keyaee/practicum/parts/controller/IMG_2561.JPG

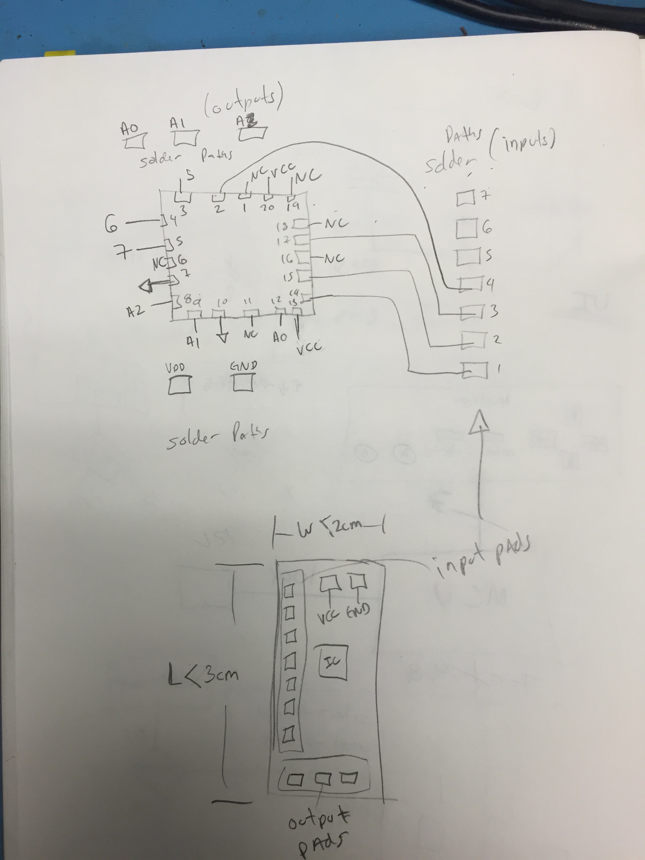
parts/controller/IMG_2561.JPG
