keyaee/practicum/images/ECE411 Lock Box - 1.jpg

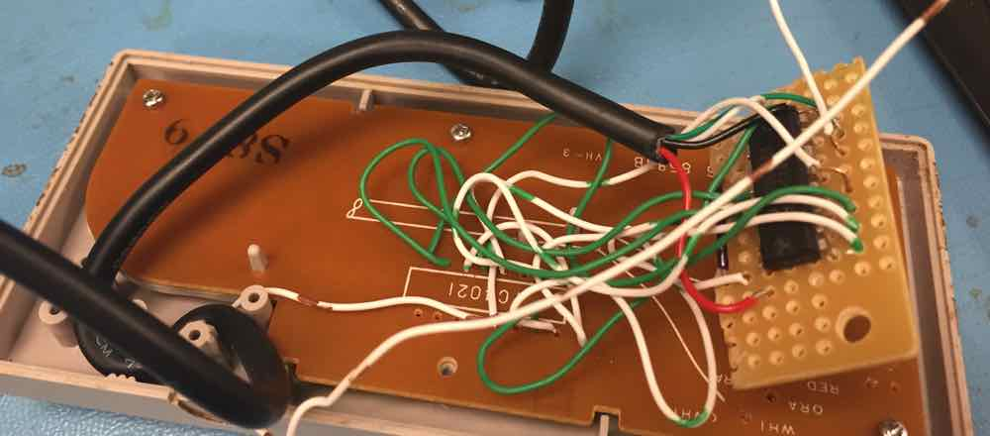
images/ECE411 Lock Box - 1.jpg
