keyaee/practicum/images/411blockDiagram.jpg

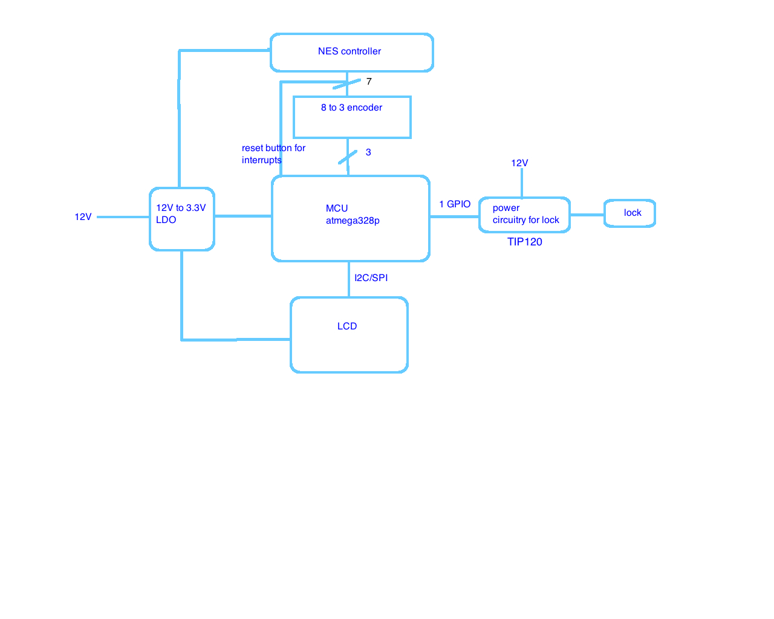
images/411blockDiagram.jpg
