keyaee/practicum/images/controller.jpg

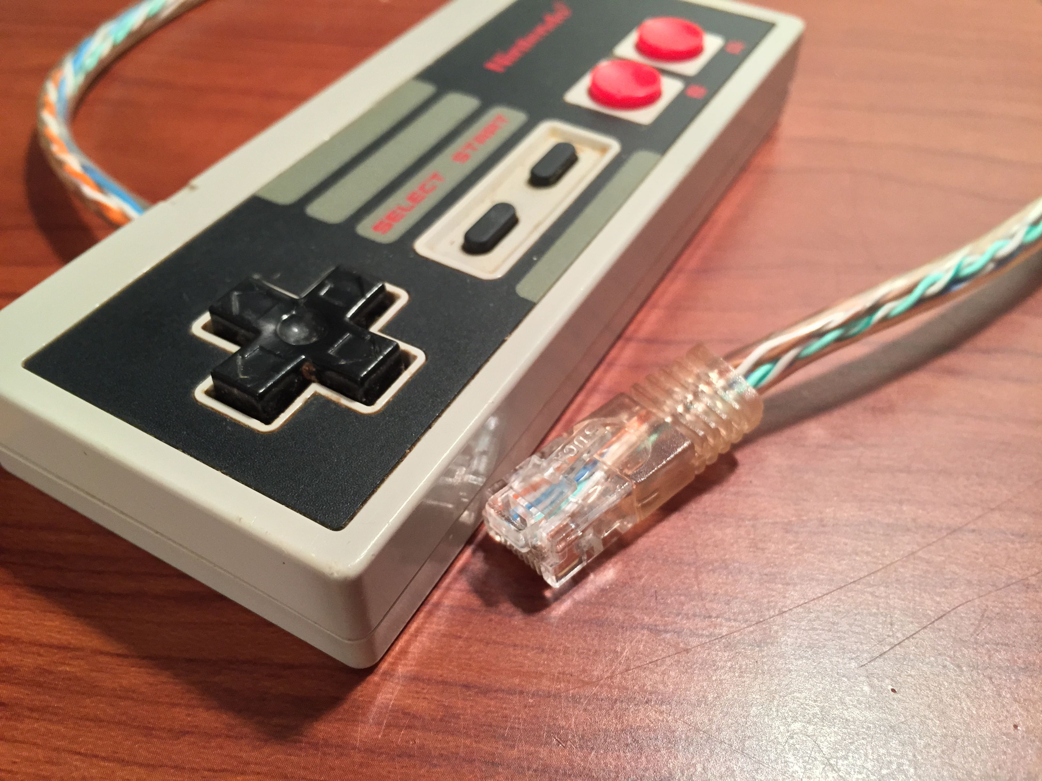
images/controller.jpg
