keyaee/practicum/images/ECE411 Lock Box - 2.jpg

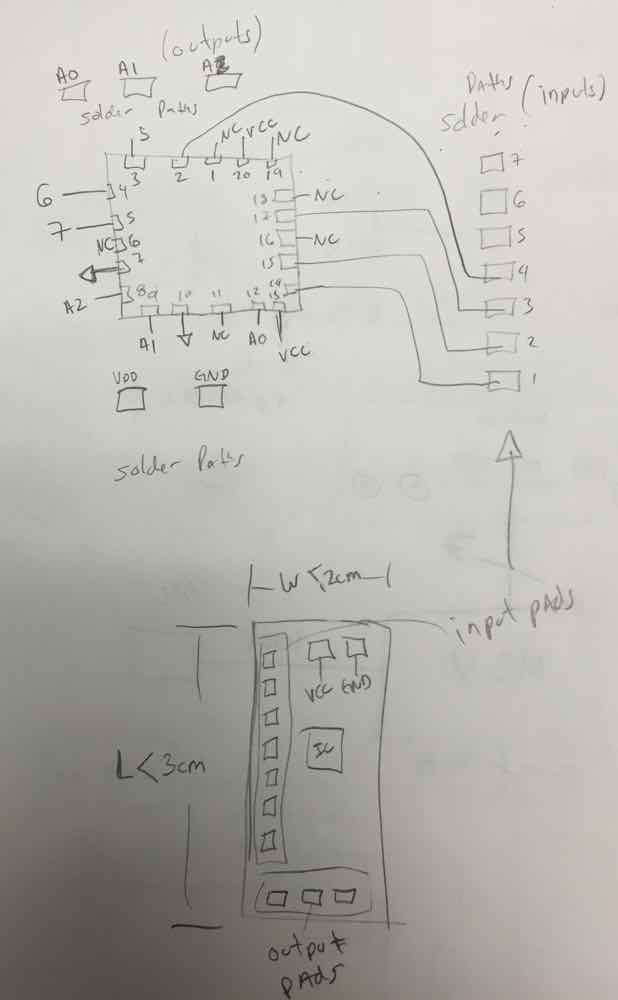
images/ECE411 Lock Box - 2.jpg
