keyaee/practicum/images/ECE411 Lock Box - 3.jpg

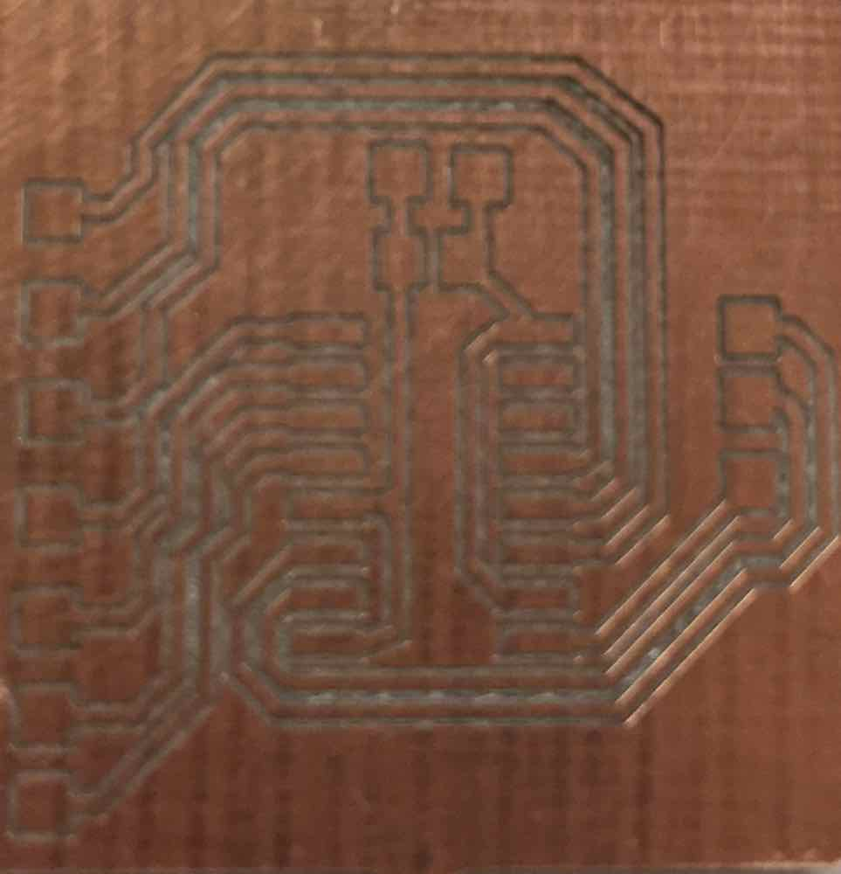
images/ECE411 Lock Box - 3.jpg
