keyaee/practicum/images/ECE411 Lock Box - 4.jpg

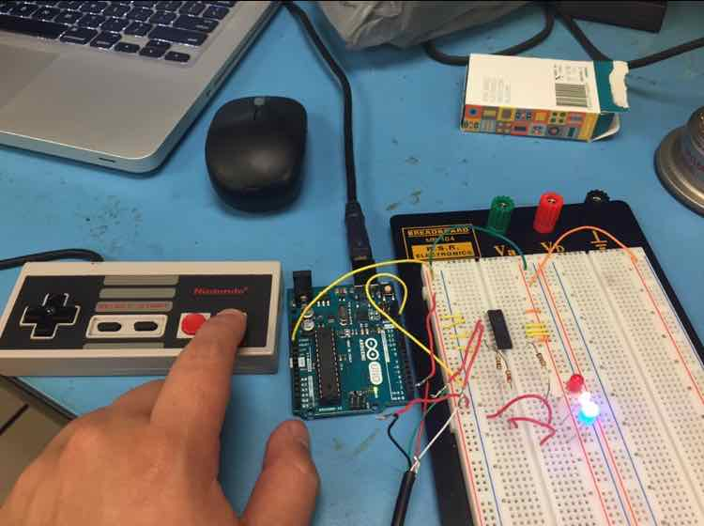
images/ECE411 Lock Box - 4.jpg
