keyaee/practicum/images/ECE411 Lock Box - 5.jpg

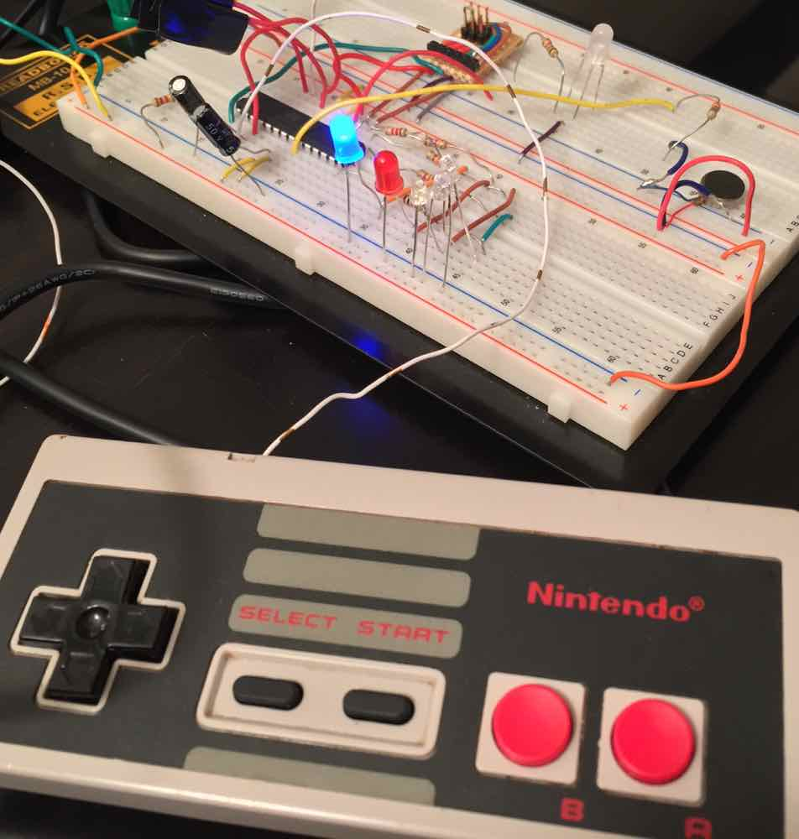
images/ECE411 Lock Box - 5.jpg
