keyaee/practicum/images/program_flow.png

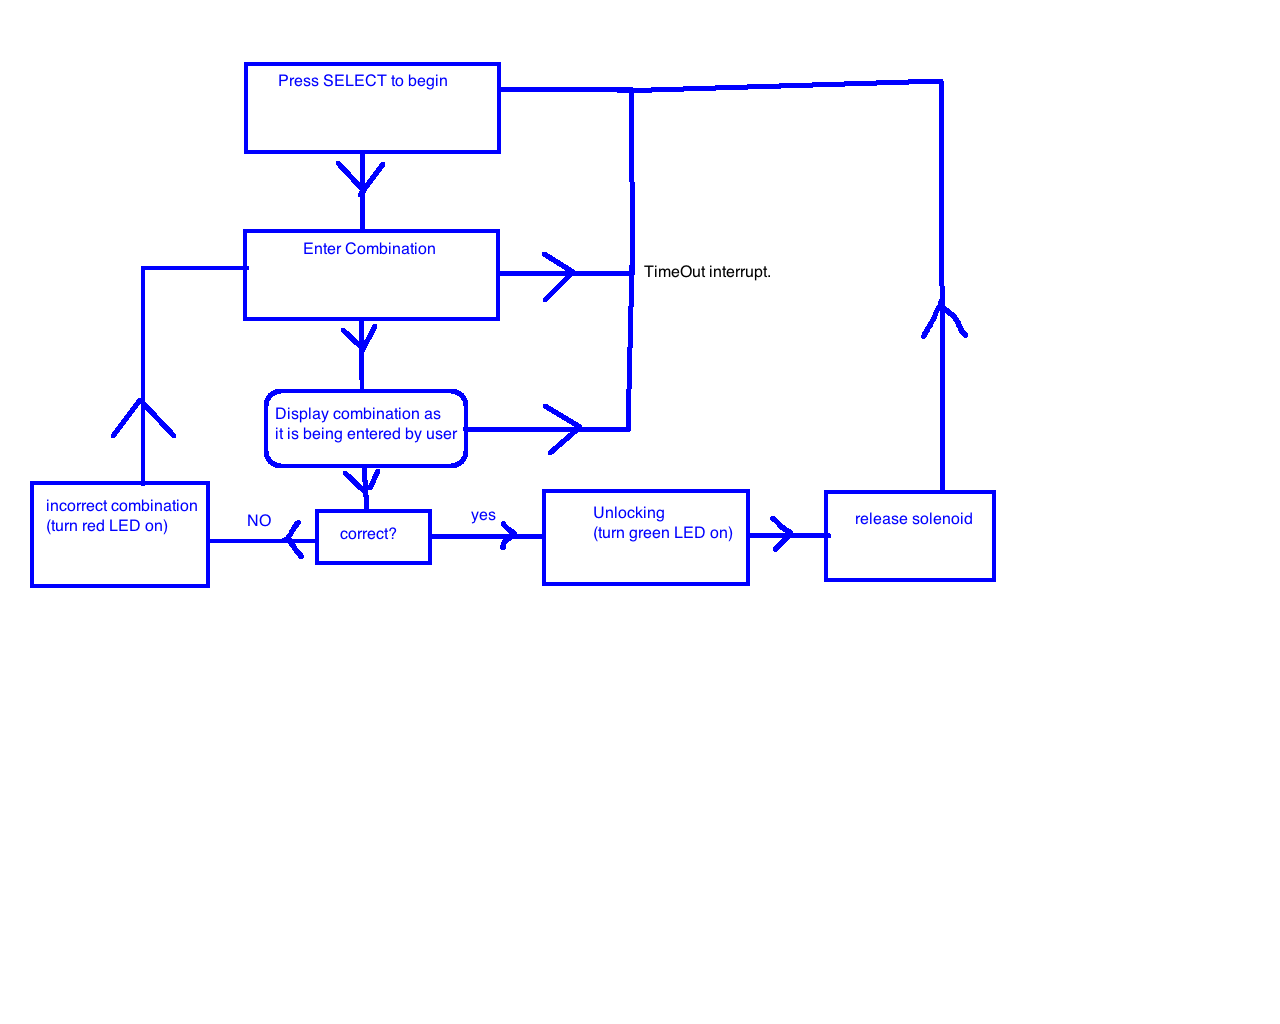
images/program_flow.png
