keyaee/practicum/Invoices/CM_3.png

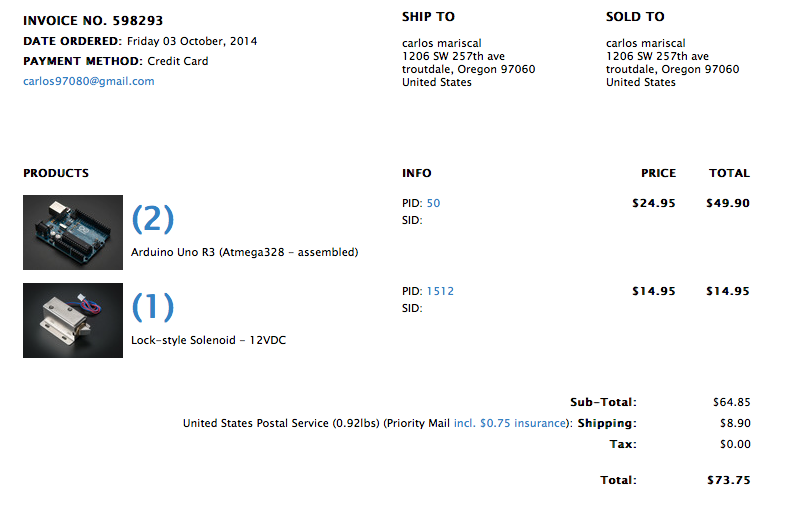
Invoices/CM_3.png
