keyaee/practicum/parts/controller/2hysical_Ethernet_Pinout_2.png

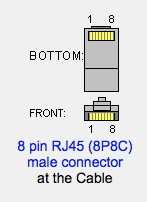
parts/controller/2hysical_Ethernet_Pinout_2.png
