keyaee/practicum/parts/controller/Controller_pinout.png

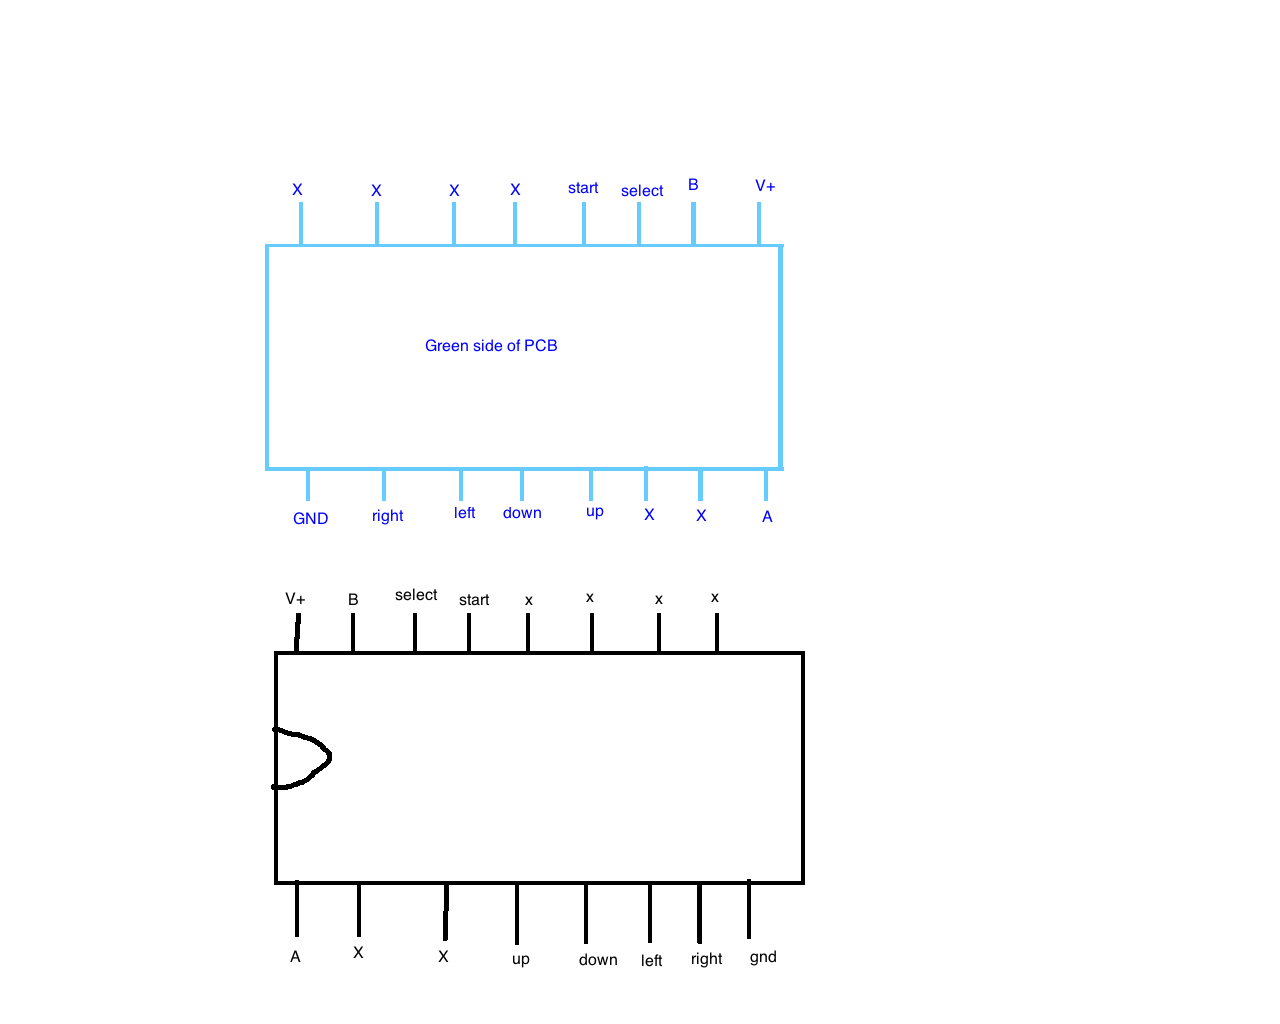
parts/controller/Controller_pinout.png
