keyaee/practicum/parts/controller/Physical_Ethernet_Pinout_1.png

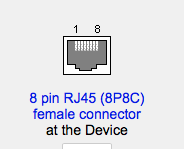
parts/controller/Physical_Ethernet_Pinout_1.png
