keyaee/practicum/parts/controller/controller_schem.png

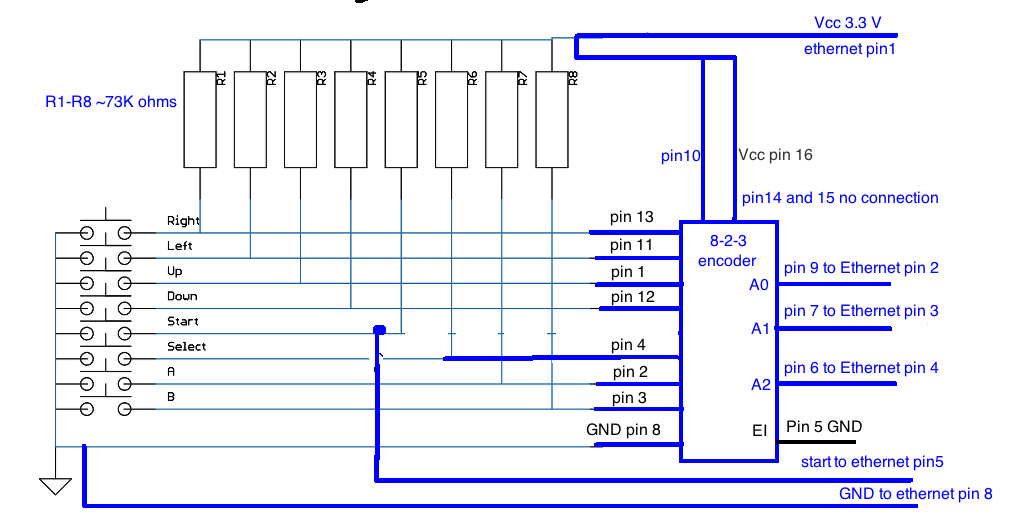
parts/controller/controller_schem.png
