keyaee/practicum/parts/MCU_atmega328p/AVR_Tutorial.rtf

follow this link for a good playlist of AVR programming tutorial

https://www.youtube.com/playlist?list=PLE72E4CFE73BD1DE1
