keyaee/practicum/eagle/T06_LockBox.brd

## EAGLE design eagle/T06_LockBox.brd (2014-11-07)

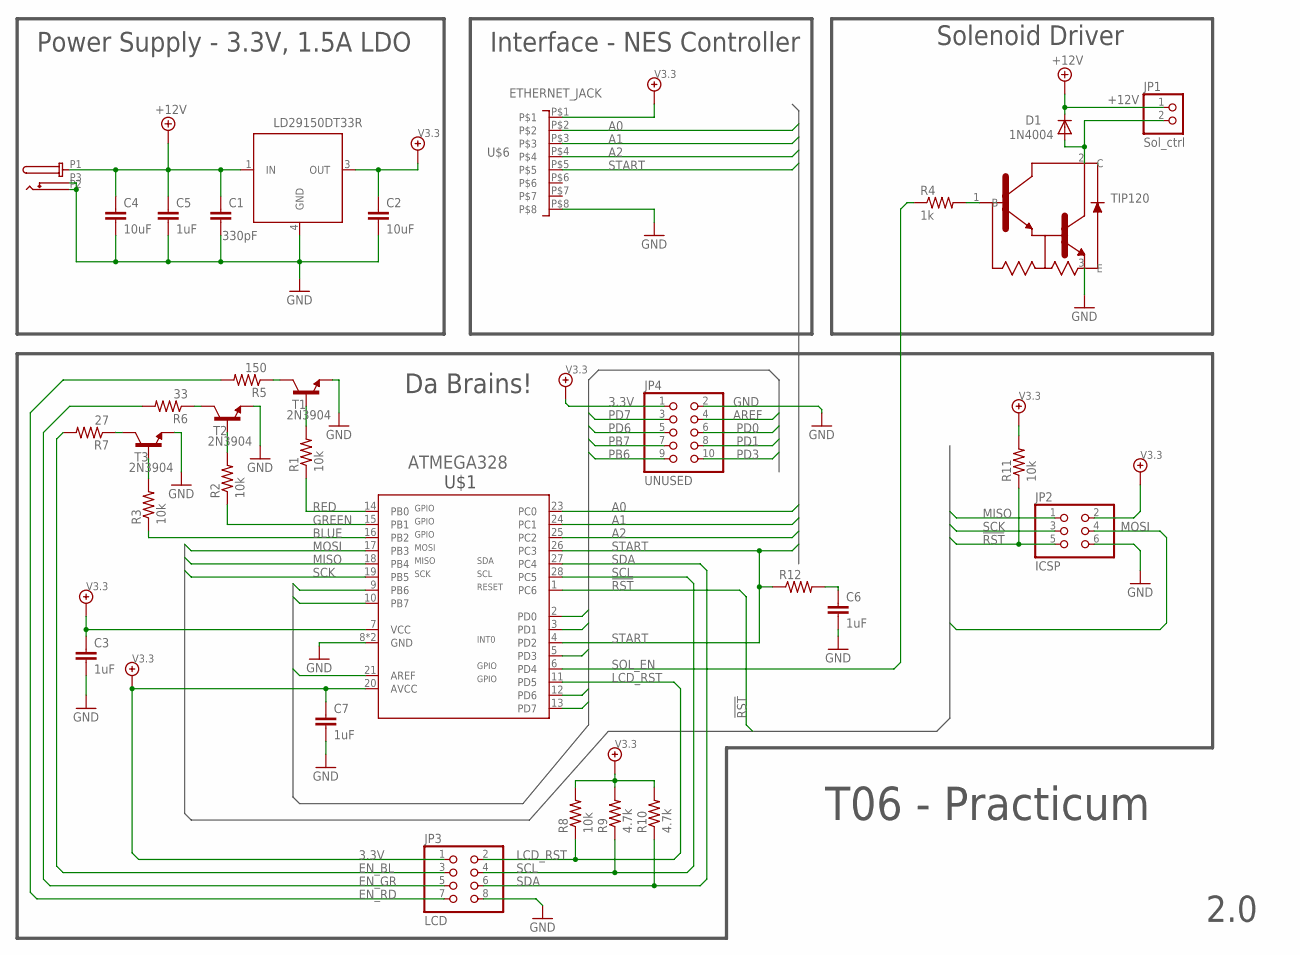
[picture p16: schematic T06_LockBox.sch]

Parts:
C1: 330pF; C0805
C2: 10uF; C0805
C3, C5, C6, C7: 1uF; C0805
C4: 10uF; C1206
D1: 1N4004; DO41-10
JP1: Sol_ctrl; 1X02
JP2: ICSP; 2X03
JP3: LCD; 2X04
JP4: UNUSED; 2X05
R1, R2, R3, R8: 10k; R0805
R4: 1k; M0805
R5: 150; R0805
R6: 33; R0805
R7: 27; R0805
R9, R10: 4.7k; R0805
R11: 10k; M0805
R12: R-US_M0805; M0805
T1, T2, T3: 2N3904; TO92-BCE
U$1: ATMEGA328; DIL28-3
U$2: LD29150DT33R; DPAK
U$3: PJ-102A
U$4: TIP120; T0220-3
U$6: ETHERNET_JACK; MODJACK8

Connections:
3.3V: C2.1, C3.1, C7.1, JP2.2, JP3.1, JP4.1, R8.2, R9.2, R10.2, R11.2, U$1.7 (VCC), U$1.20 (AVCC), U$2.3 (OUT), U$6.P$1
!RST: JP2.5, R11.1, U$1.1 (PC6)
+12V: C1.1, C4.1, C5.1, D1.C, JP1.1, U$2.1 (IN), U$3.P1 (PWR)
A0: U$1.23 (PC0), U$6.P$2
A1: U$1.24 (PC1), U$6.P$3
A2: U$1.25 (PC2), U$6.P$4
AREF: JP4.4, U$1.21 (AREF)
BLUE: R3.1, U$1.16 (PB2)
EN_BL: JP3.3, R7.2
EN_GR: JP3.5, R6.2
EN_RD: JP3.7, R5.2
GND: C1.2, C2.2, C3.2, C4.2, C5.2, C6.2, C7.2, JP2.6, JP3.8, JP4.2, T1.E, T2.E, T3.E, U$1.8 (GND), U$1.22 (GND), U$2.4 (GND), U$3.P2 (GND), U$3.P3 (GND), U$4.3 (E), U$6.P$8
GREEN: R2.1, U$1.15 (PB1)
LCD_RST: JP3.2, R8.1, U$1.11 (PD5)
MISO: JP2.1, U$1.18 (PB4)
MOSI: JP2.4, U$1.17 (PB3)
unnamed: R4.2, U$4.1 (B)
unnamed: C6.1, R12.2
unnamed: D1.A, JP1.2, U$4.2 (C)
unnamed: R1.2, T1.B
unnamed: R2.2, T2.B
unnamed: R3.2, T3.B
unnamed: R7.1, T3.C
unnamed: R6.1, T2.C
unnamed: R5.1, T1.C
PB6: JP4.9, U$1.9 (PB6)
PB7: JP4.7, U$1.10 (PB7)
PD0: JP4.6, U$1.2 (PD0)
PD1: JP4.8, U$1.3 (PD1)
PD3: JP4.10, U$1.5 (PD3)
PD6: JP4.5, U$1.12 (PD6)
PD7: JP4.3, U$1.13 (PD7)
RED: R1.1, U$1.14 (PB0)
SCK: JP2.3, U$1.19 (PB5)
SCL: JP3.4, R9.1, U$1.28 (PC5)
SDA: JP3.6, R10.1, U$1.27 (PC4)
SOL_EN: R4.1, U$1.6 (PD4)
START: R12.1, U$1.4 (PD2), U$1.26 (PC3), U$6.P$5

Notes on the sheet:
Power Supply - 3.3V, 1.5A LDO
Interface - NES Controller
Solenoid Driver
T06 - Practicum
2.0
Da Brains!

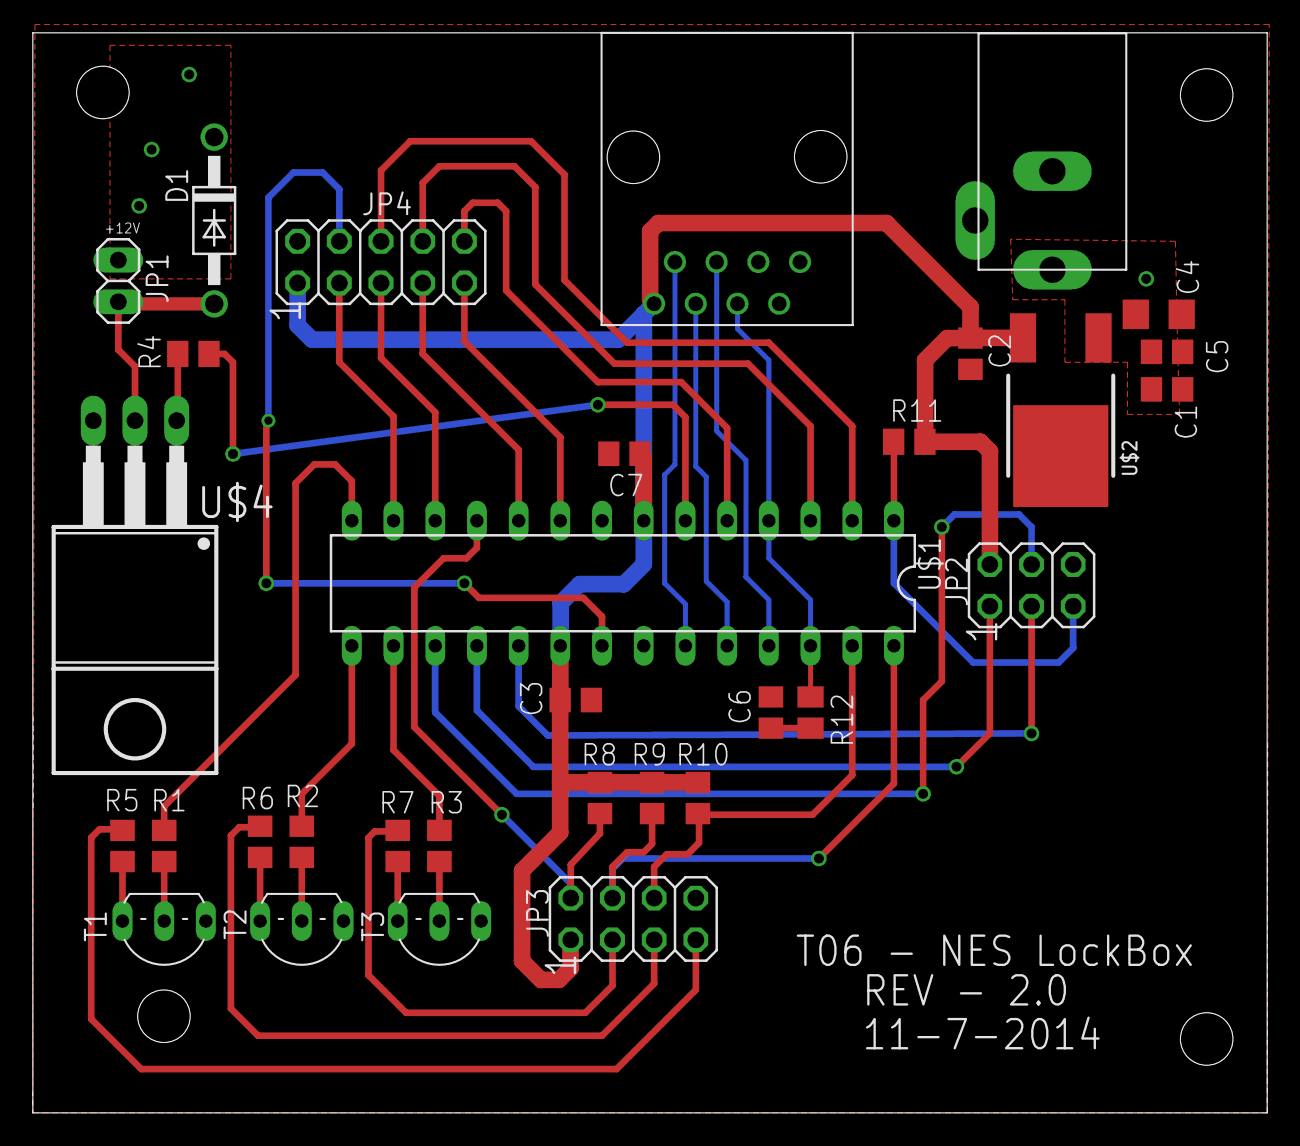
[picture p17: board T06_LockBox.brd from above]

Board: 2 copper layers, 75.2 x 65.8 mm, 32 parts (0 on the bottom side), 38 nets.
