keyaee/practicum/eagle/LCD/LCD_board.brd

## EAGLE design eagle/LCD/LCD_board.brd (2014-11-07)

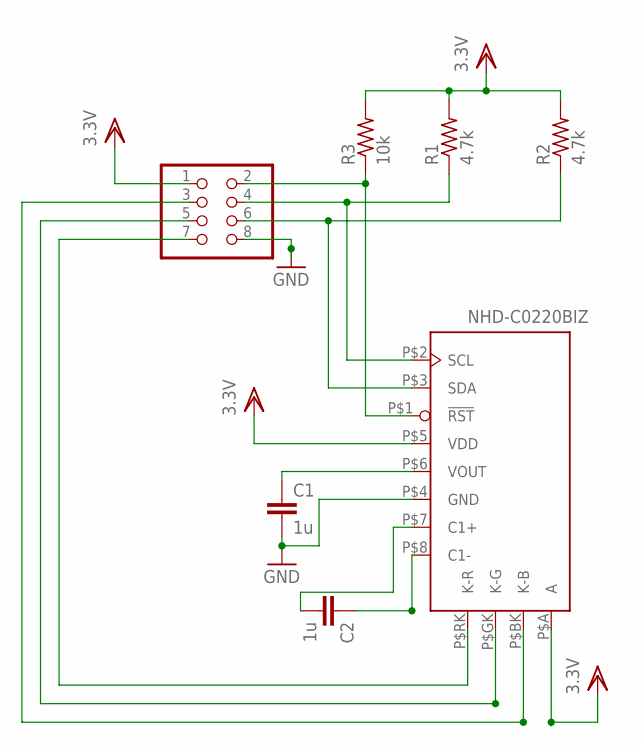
[picture p18: schematic LCD_board.sch]

Parts:
C1, C2: 1u; C0805
DATALINES: To MPU; 2X04
R1, R2: 4.7k; M0805
R3: 10k; M0805
U$1: NHD-C0220BIZ; NHD-C0220BIZ-LCD

Connections:
3.3V: DATALINES.1, R1.2, R2.2, R3.2, U$1.P$5 (VDD), U$1.P$A (A)
!LCD_RST: DATALINES.2, R3.1, U$1.P$1 (!RST)
C1+: C2.2, U$1.P$7 (C1+)
EN_BL: DATALINES.3, U$1.P$BK (K-B)
EN_G: DATALINES.5, U$1.P$GK (K-G)
EN_RD: DATALINES.7, U$1.P$RK (K-R)
GND: C1.2, DATALINES.8, U$1.P$4 (GND)
unnamed: C2.1, U$1.P$8 (C1-)
unnamed: C1.1, U$1.P$6 (VOUT)
SCL: DATALINES.4, R1.1, U$1.P$2 (SCL)
SDA: DATALINES.6, R2.1, U$1.P$3 (SDA)

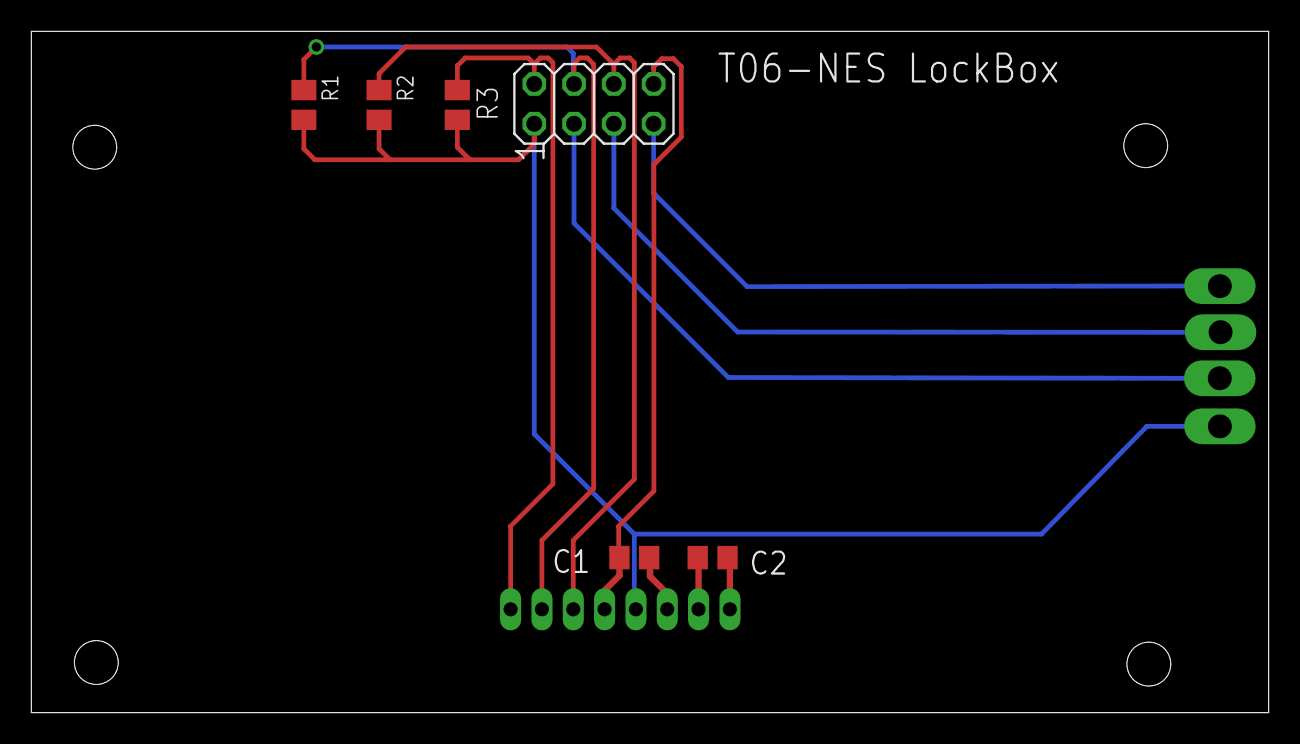
[picture p19: board LCD_board.brd from above]

Board: 2 copper layers, 79.0 x 43.5 mm, 7 parts (1 on the bottom side), 11 nets.
