keyaee/practicum/eagle/encoder/ctrl_encoder.brd

## EAGLE design eagle/encoder/ctrl_encoder.brd (2014-10-22)

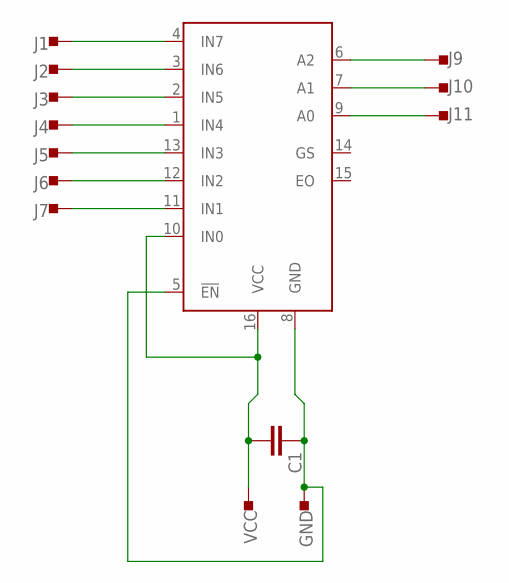
[picture p20: schematic ctrl_encoder.sch]

Parts:
C1: C; C0805
GND: PAD; TEST_PAD
J1, J2, J3, J4, J5, J6, J7, J9, J10, J11: PAD; TEST_PAD
U$1: SN74HC148DR; SO16
VCC: PAD; TEST_PAD

Connections:
GND: C1.1, GND.P$1, U$1.5 (!EN), U$1.8 (GND)
unnamed: C1.2, U$1.10 (IN0), U$1.16 (VCC), VCC.P$1
unnamed: J9.P$1, U$1.6 (A2)
unnamed: J1.P$1, U$1.4 (IN7)
unnamed: J2.P$1, U$1.3 (IN6)
unnamed: J3.P$1, U$1.2 (IN5)
unnamed: J4.P$1, U$1.1 (IN4)
unnamed: J5.P$1, U$1.13 (IN3)
unnamed: J6.P$1, U$1.12 (IN2)
unnamed: J7.P$1, U$1.11 (IN1)
unnamed: J10.P$1, U$1.7 (A1)
unnamed: J11.P$1, U$1.9 (A0)

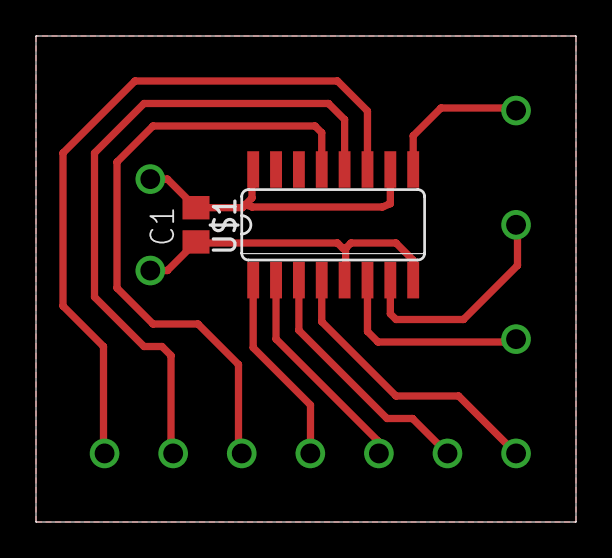
[picture p21: board eagle/encoder/ctrl_encoder.brd from above]

Board: 2 copper layers, 30.0 x 27.0 mm, 14 parts (0 on the bottom side), 12 nets.
