keyaee/practicum/eagle/ctrl_encoder.brd

## EAGLE design eagle/ctrl_encoder.brd (2014-10-16)

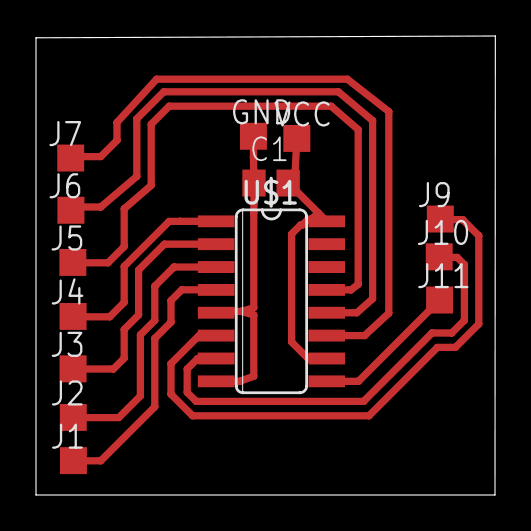
[picture p22: board eagle/ctrl_encoder.brd from above]

Board: 2 copper layers, 25.5 x 25.5 mm, 14 parts (0 on the bottom side), 12 nets.

Parts:
C1: C0805
GND: PAD+SQUARE-1.5X1.5; PAD-1.5X1.5
J1, J2, J3, J4, J5, J6, J7, J9, J10, J11: PAD+SQUARE-1.5X1.5; PAD-1.5X1.5
U$1: SN74HC148DR; SO16
VCC: PAD+SQUARE-1.5X1.5; PAD-1.5X1.5

Connections:
GND: C1.1, GND.PAD, U$1.5, U$1.8
unnamed: C1.2, U$1.10, U$1.16, VCC.PAD
unnamed: J9.PAD, U$1.6
unnamed: J1.PAD, U$1.4
unnamed: J2.PAD, U$1.3
unnamed: J3.PAD, U$1.2
unnamed: J4.PAD, U$1.1
unnamed: J5.PAD, U$1.13
unnamed: J6.PAD, U$1.12
unnamed: J7.PAD, U$1.11
unnamed: J10.PAD, U$1.7
unnamed: J11.PAD, U$1.9
