keyaee/practicum/parts/MCU_atmega328p/understanding_interrupts/TASK1/TASK1/ext_interrupt_driver.c

/*! \file *********************************************************************
 *
 * \brief  ATmega2560 External interrupts driver source file.
 *
 *      This file contains the function implementations the external interrupts
 *      driver.
 *
 *      The driver is not intended for size and/or speed critical code, since
 *      some functions are several lines of code, and the function call
 *      overhead would decrease code performance. The driver is intended for
 *      rapid prototyping and documentation purposes for getting started with
 *      the ATmega2560 external interrupts.
 *
 *      For size and/or speed critical code, it is recommended to copy the
 *      function contents directly into your application instead of making
 *      a function call.
 *
 * \par Application note:
 *      AVR1200: Using external interrupts for megaAVR devices
 *
 * \par Documentation
 *      For comprehensive code documentation, supported compilers, compiler
 *      settings and supported devices see readme.html
 *
 * \author
 *      Atmel Corporation: http://www.atmel.com \n
 *      Support email: avr@atmel.com
 *
 * Copyright (c) 2011, Atmel Corporation All rights reserved.
 *
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
 * 3. The name of ATMEL may not be used to endorse or promote products derived
 * from this software without specific prior written permission.
 *
 * THIS SOFTWARE IS PROVIDED BY ATMEL "AS IS" AND ANY EXPRESS OR IMPLIED
 * WARRANTIES, INCLUDING, BUT NOT LIMITED TO, THE IMPLIED WARRANTIES OF
 * MERCHANTABILITY AND FITNESS FOR A PARTICULAR PURPOSE ARE EXPRESSLY AND
 * SPECIFICALLY DISCLAIMED. IN NO EVENT SHALL ATMEL BE LIABLE FOR ANY DIRECT,
 * INDIRECT, INCIDENTAL, SPECIAL, EXEMPLARY, OR CONSEQUENTIAL DAMAGES
 * (INCLUDING, BUT NOT LIMITED TO, PROCUREMENT OF SUBSTITUTE GOODS OR SERVICES;
 * LOSS OF USE, DATA, OR PROFITS; OR BUSINESS INTERRUPTION) HOWEVER CAUSED AND
 * ON ANY THEORY OF LIABILITY, WHETHER IN CONTRACT, STRICT LIABILITY, OR TORT
 * (INCLUDING NEGLIGENCE OR OTHERWISE) ARISING IN ANY WAY OUT OF THE USE OF
 * THIS SOFTWARE, EVEN IF ADVISED OF THE POSSIBILITY OF SUCH DAMAGE.
 *****************************************************************************/

/*! \brief This function configures the external interrupt to sense either
 *         rising edge, falling edge, both the edges or low level to
 *         rise an interrupt request.
 *  \param INT_NO	The interrupt for which configuration has to be setup.
 *  \param INT_MODE	The sensing mode of the INT_NO.
 */
void Configure_Interrupt(uint8_t INT_NO, uint8_t INT_MODE)
{
	switch(INT_NO)
	{
	case 0: switch(INT_MODE)
		{
		case 0:EICRA=(EICRA&(~(1<<ISC01|1<<ISC00)))|(0<<ISC01|0<<ISC00);
			break;
		case 1:EICRA=(EICRA&(~(1<<ISC01|1<<ISC00)))|(0<<ISC01|1<<ISC00);
			break;
		case 2:EICRA=(EICRA&(~(1<<ISC01|1<<ISC00)))|(1<<ISC01|0<<ISC00);
			break;
		case 3:EICRA=(EICRA&(~(1<<ISC01|1<<ISC00)))|(1<<ISC01|1<<ISC00);
			break;
		default:break;
		}
		break;

	case 1: switch(INT_MODE)
		{
		case 0:EICRA=(EICRA&(~(1<<ISC11|1<<ISC10)))|(0<<ISC11|0<<ISC10);
			break;
		case 1:EICRA=(EICRA&(~(1<<ISC11|1<<ISC10)))|(0<<ISC11|1<<ISC10);
			break;
		case 2:EICRA=(EICRA&(~(1<<ISC11|1<<ISC10)))|(1<<ISC11|0<<ISC10);
			break;
		case 3:EICRA=(EICRA&(~(1<<ISC11|1<<ISC10)))|(1<<ISC11|1<<ISC10);
			break;
		default:break;
		}
		break;

	case 2: switch(INT_MODE)
		{
		case 0:EICRA=(EICRA&(~(1<<ISC21|1<<ISC20)))|(0<<ISC21|0<<ISC20);
			break;
		case 1:EICRA=(EICRA&(~(1<<ISC21|1<<ISC20)))|(0<<ISC21|1<<ISC20);
			break;
		case 2:EICRA=(EICRA&(~(1<<ISC21|1<<ISC20)))|(1<<ISC21|0<<ISC20);
			break;
		case 3:EICRA=(EICRA&(~(1<<ISC21|1<<ISC20)))|(1<<ISC21|1<<ISC20);
			break;
		default:break;
		}
		break;

	case 3: switch(INT_MODE)
		{
		case 0:EICRA=(EICRA&(~(1<<ISC31|1<<ISC30)))|(0<<ISC31|0<<ISC30);
			break;
		case 1:EICRA=(EICRA&(~(1<<ISC31|1<<ISC30)))|(0<<ISC31|1<<ISC30);
			break;
		case 2:EICRA=(EICRA&(~(1<<ISC31|1<<ISC30)))|(1<<ISC31|0<<ISC30);
			break;
		case 3:EICRA=(EICRA&(~(1<<ISC31|1<<ISC30)))|(1<<ISC31|1<<ISC30);
			break;
		default:break;
		}
		break;

	case 4: switch(INT_MODE)
		{
		case 0:EICRB=(EICRB&(~(1<<ISC41|1<<ISC40)))|(0<<ISC41|0<<ISC40);
			break;
		case 1:EICRB=(EICRB&(~(1<<ISC41|1<<ISC40)))|(0<<ISC41|1<<ISC40);
			break;
		case 2:EICRB=(EICRB&(~(1<<ISC41|1<<ISC40)))|(1<<ISC41|0<<ISC40);
			break;
		case 3:EICRB=(EICRB&(~(1<<ISC41|1<<ISC40)))|(1<<ISC41|1<<ISC40);
			break;
		default:break;
		}
		break;

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
		break;
	case 23:PCMSK2=(PCMSK2&(~(1<<PCINT23)));
		break;
	default:break;
	}
	if(PCMSK0 == 0x00)
	{
		PCICR=(PCICR&(~(1<<PCIE0)));
	}
	else if(PCMSK1 == 0x00)
	{
		PCICR=(PCICR&(~(1<<PCIE1)));
	}
	else if(PCMSK2 == 0x00)
	{
		PCICR=(PCICR&(~(1<<PCIE2)));
	}
}
