keyaee/practicum/code/Lock_Box/Lock_Box_5/Lock_Box_5/Lock_Box_5.c

/*
 * Lock_Box_5.c
 *
 * Created: 11/7/2014 11:31:55 AM
 *  Author: carlos97080
 */ 


#include <avr/io.h>

int main(void)
{
    while(1)
    {
        //TODO:: Please write your application code 
    }
}
