keyaee/practicum/(commit log)

2014-10-08 adding parts with data sheets and supporting files
    [package comparison.xlsx]
2014-10-08 spread sheet for keeping track of expenses
    add the parts that you have bought and cost so we can keep track of
    expenses
    [expenses_Paid.xlsx]
2014-10-08 new schematic for controller
2014-10-09 updates and adding a folder for invoices
    [expenses_Paid.xlsx]
2014-10-09 Started LockBox.lbr and added the ATMEGA328 symbol/footprint
2014-10-10 Added LCD screen footprint and schematic to library
2014-10-10 Added Capacitor symbol/footprint to LockBox.lbr
2014-10-11 adding some schematics and data sheets
2014-10-11 Added LDO schematic and footprint to LockBox.lbr
2014-10-11 power connector added
2014-10-11 Added TIP120 Darlington Transistor footprint and schematic to Lockbox.lbr
2014-10-11 LCD board
    Jeff, I do have some issues
    [LCD_board.brd, LCD_board.sch]
2014-10-12 Moved ARGB pins on LCD screen schematic to match physical location. This should solve issue #9. Updated LCD_board.sch to reflect these changes.
    [LCD_board.brd, LCD_board.sch]
2014-10-12 Added S016 package to the 8:3 encoder
2014-10-12 Created footprint for the DC power jack
2014-10-12 Added symbol for the DC power jack to the LockBox.lbr
2014-10-12 Arduino pin out vs. atmega328
    [arduino_2_328_PinOut.xlsx]
2014-10-12 cleaning up atmega328 folder
    [package comparison.xlsx]
2014-10-12 link to programming AVR (great resource)
    [expenses_Paid.xlsx]
2014-10-13 Deleted duplicate LCD_board.b#d and LCD_board.brd from eagle directory. Created a new LCD_board.brd file that no longer causes errors when trying to open it via eagle
    [LCD_board.brd]
2014-10-13 Routed wires for the LCD_board.brd file. Most of the errors were removed when running DRC with the EPL design rules supplied from git. Also removed the drills fron the LDC sceen footprint. When placi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
    There is still an error on the LDC_board.brd which seems to be related to the 8pins and the outline of the LDC sceen. I think these can be ignored but I need to check on these.
    [LCD_board.brd, LCD_board.sch]
2014-10-13 DRC errors in the LCD_board.brd have been resolved. Traces have been routed and the board should be good to go.
    [LCD_board.brd, LCD_board.sch]
2014-10-15 Added resistors to LockBox.lbr
2014-10-16 created ctrl encoder board and schematic.
    [ctrl_encoder.brd, ctrl_encoder.sch]
2014-10-16 small changes
    [ctrl_encoder.brd, ctrl_encoder.sch]
2014-10-16 minor change
    [wirering_prototype.xlsx]
2014-10-16 LCD board with pull up resistor
    This should give us a working screen with thru hole components just to
    check dimensions and use for debug. Next change resistor and capacitor
    for surface mount and determine if RGB resistors will be on this or the
    main board.
    [LCD_board.brd, LCD_board.sch]
2014-10-16 Added gerber files folders
    The name are a redundant since the extension tells you what they are
    but I thought it was the easiest way for everybody to understand
    [Top_layer.GTL, bottom_layer.GBL]
2014-10-16 Added schematic frame to the library
2014-10-16 Some gerber changes
    use better names and PSU LPKF format
    [Top_layer.GTL]
2014-10-16 LCD Gerber files
    PSU formated Gerber files for LPKF
    [LCD_board.xln]
2014-10-17 Moved ctrl_encoder.dri file to GerberFiles/encoder Renamed Gerber\ files to GerberFiles
    [LCD_board.xln]
2014-10-17 More file management, added LCD folder and encoder folder and moved appropiate files.
    [LCD_board.brd, LCD_board.sch, ctrl_encoder.brd, ctrl_encoder.sch]
2014-10-17 moved j1-j8 pins up on the ctrl_encoder.brd shrinking the actual size of the encoder board by several mm.
    [ctrl_encoder.brd]
2014-10-17 minor updates
    [wirering_prototype.xlsx]
2014-10-18 blah blka
    [wirering_prototype.xlsx]
2014-10-18 controller driver
2014-10-19 uptades
    added invoice for eBay
    [expenses_Paid.xlsx]
2014-10-20 Started the LockBox schematic. I need pin assignments for tha ATMEL chip to make much more progress.
    [LockBox.sch]
2014-10-20 updates
    updated controller schematic
    added basic program flow
    updated pin out to MCU and encoder
    [arduino_2_328_PinOut.xlsx]
2014-10-20 Added ground symbol to LockBox.lbr
2014-10-20 Modified the ATMEL chip schematic in LockBox.lbr, the schematic now updates properly when adding attributes to the port/pins in LockBox.sch.
2014-10-20 Finished the powersupply and LDO portion of the LockBox.sch, Added pwr/gnd and bypass cap to the ATMEL chip, updateded I2C pin attributes and added I2C bus.
    [LockBox.sch]
2014-10-20 Added I2C bus and pull up resistors to the LCD screen.
    [LockBox.sch]
2014-10-20 Added gnd and vout connections to the LCD screen in LockBox.sch Moved pins and modified part name in LockBox.lbr. These pins were poorly placed and were moved to allow for a cleaner schematic in Lock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
    [LockBox.sch]
2014-10-20 Added KR, KG, KB, and A connections to the LCD screen.
    [LockBox.sch]
2014-10-20 Updated LCD_board.sch with modified LCD screen schematic.
    [LCD_board.brd, LCD_board.sch]
2014-10-20 LCD_board.brd is now a one layer board. Created new Gerber files and updated the GerberFiles/LCD directory with these new files
    [LCD_board.brd, LCD_board.sch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]
2014-10-20 creating folders
    I created new folders in the gerber folder so we can hold different
    versions of board layouts
    [LCD_board.xln]
2014-10-20 updated ATMEL chip pin allocation.
    [arduino_2_328_PinOut.xlsx]
2014-10-21 Modified the symbol on the TIP120. The grid of the schematic was on an off scale making it difficult to make wire connections when using the part in the LockBox.sch.
2014-10-21 Added the TIP120 to LockBox.sch
    [LockBox.sch]
2014-10-21 Added 0.6mm drill Test pad to LockBox.lbr
2014-10-21 Replaced surface mount pads with through hole pads. Added a polygon to the .brd and increased the size of the isolate from 10mil to 20mils, this should prevent solder from bridging to the remaining c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
    [ctrl_encoder.brd, ctrl_encoder.sch]
2014-10-21 Removed previous gerber files and added new updated gerber files
    [LCD_Board.xln]
2014-10-21 Ver2 Gerber files for encoder
    Per Carlos request created new Gerber files for encoder with thru hole.
    [ctrl_encoder.xln]
2014-10-21 Added ethernet jack symbol and footprint to LockBox.lbr
2014-10-21 program flow change
    SELECT button will cause interrupt only in first screen
2014-10-21 updating pin out
    [arduino_2_328_PinOut.xlsx, wirering_prototype.xlsx]
2014-10-21 datasheet for diode in parallel with solenoid
2014-10-21 Added 2pin header and 12V supply symbol to LockBox.lbr
    [LockBox.sch]
2014-10-21 First draft of LockBox.sch is complete and ready for review
    [LockBox.sch]
2014-10-21 changed pin out
    had to change the pinout of the MCU because the outputs of the
    Controller are pull ups and one of the pins I was using was the same
    for the SPI bus which need to be free not pulled high or else
    programming would not be possible
    [arduino_2_328_PinOut.xlsx]
2014-10-21 Added bus and related nets for LED color control on the LCD screen
    [LockBox.sch]
2014-10-22 changes on pinout
    [arduino_2_328_PinOut.xlsx]
2014-10-22 adding new Driver for controller
    this code contains an update for the controller driver and also
    includes examples on external interrupts and timer interrupts
2014-10-22 Increased the size of the thruhole pads from 0.6mm to 1.1mm
    [ctrl_encoder.brd, ctrl_encoder.sch]
2014-10-22 Increased the size of the test pad through hole from 0.6mm to 1.1mm
2014-10-24 Lock Box code
    the code is mostly done. we only need to develop drivers for the LCD. I
    tried to comment most of the code I will continue to add comments ASAP.
    [arduino_2_328_PinOut.xlsx]
2014-10-25 File management: I cleaned up the practicum directory
    [expenses_Paid.xlsx]
2014-10-25 Minor changes and suggestions
    Used track changes and comments to identify my ideas and make it easy
    to accept or reject. Made a few comments and observations to make
    marketing and engineering requirements a bit more different.
2014-10-26 file upkeeping
    deleted files that were associated with Atmel Studio. the code folder
    should only contain .ccp and .h files.
    * lock box code now can handle the user holding down a button without
    registering as an continuous input
2014-10-28 Added AVCC connection to VCC on the ATMEL chip. Added document number.
    [LockBox.sch]
2014-10-29 Routed LCD From Bottom
    Routed from bottom. Have it closer to what we need to ask Andrew for
    suggestions on LED Hole (currently is not wide enough)
    [LCD_board.brd]
2014-10-30 LCD RGB has the modified width
    Change the hole width of the RGB pinto fit the pins. I hope…
2014-10-30 adjusted hight
    after hole size adjustment hight was a bit off and readjusted to match
    data sheet
    [LCD_board.brd, LCD_board.sch]
2014-10-30 adding some files
    added images for controller prototype, ethernet pin out, edits on
    encoder schmeatic
    [arduino_2_328_PinOut.xlsx]
2014-10-30 Updates
    made changes to encoder schematic. changed the SELECT button for the
    START button. instead of pressing SELECT to begin it is now the START
    button
    [arduino_2_328_PinOut.xlsx]
2014-10-31 Added 6pin 2x3 headder to the Lockbox.sch. Routed necessary nets associated with programing the ATMEL chip. A switch will need to be added for the RESET. This schematic version is 1.1.
    [LockBox.sch]
2014-10-31 Moved EN_RD from PB1 to PB0 and EN_GR from PB0 to PB1, this change was necessary to aid in board layout
    [LockBox.sch]
2014-10-31 Started LockBox.brd layout
    [LockBox.brd]
2014-10-31 Finished first draft of board layout. I have not ran a DRU yet because I dont have the OSHPARK DRU files.
    [LockBox.brd, LockBox.sch]
2014-10-31 Removed the LCD screen from the .sch and inserted a pin header in its place.
    [LockBox.brd, LockBox.sch]
2014-11-01 Added transister pulldown network for LCD-LED backlighting
    [LockBox.sch]
2014-11-01 Renamed eagle files to include group name as per Andrews request
    [T06_LockBox.brd, T06_LockBox.sch]
2014-11-02 Added connections to unused pins on the schematic. Finished routing wires to the unused pin header locaton on the board.
    [T06_LockBox.brd, T06_LockBox.sch]
2014-11-02 Increased the drill size of the 8 inline pins on the LDC screen. The size went from 0.6mm ---> 0.8mm. This should provide plenty of room and the LCD screen should just fit
2014-11-02 Working but still alpha code fro LCD
    Initial LCD code Timing issues resolved. Good enough for testing user
    inputs.
    Still needs print fiction (ability to send strings) sf better
    comments.
2014-11-02 Finished first REV of board layout. Still need to add via's and update labeling for the t-slik layer.
    [T06_LockBox.brd]
2014-11-03 Replaced 10uF 25V 0805 cap with 1206 cap. 0805 package size with those values is not available.
    Moved the tplace labels of all components on the .brd
    [T06_LockBox.brd, T06_LockBox.sch]
2014-11-03 Added 2x5 pin headder and pull up resistor to the ATMEGA reset line.
    [T06_LockBox.brd, T06_LockBox.sch]
2014-11-04 Replaced incorrect power jack with correct power jack datasheet
2014-11-04 edits
    edits on controller/encoder schematic. made it more clear so people can
    read and wire there own controller
2014-11-04 Increased drill size from .76mm to .9mm on the ethernet jack, this should provide enough space for pin diameter variations.
    [T06_LockBox.brd, T06_LockBox.sch]
2014-11-05 layout dimension change
    will try to build tomorrow
    [LCD_board.brd]
2014-11-06 8 LDC round pads to long pads and increased diameter of the drills.
2014-11-06 Updated LCD board with surface mount components and a 2x4 header connector
    [LCD_board.brd, LCD_board.sch]
2014-11-07 Created 2 layer LDC board with smaller footprint than previous versions
    [LCD_board.brd, LCD_board.sch]
2014-11-07 Added drill holes to the LCD screen that are necessary for hardware mounting
2014-11-07 Added cap to VCC next to atmel chip, increased 3.3V trace width, text size issue was not related to our file but Andrews eagle that always displayed vector font
    [T06_LockBox.brd, T06_LockBox.sch]
2014-11-07 found one connection not routed. fixed the connection and all better :-)
    [T06_LockBox.brd]
2014-11-07 Removed code
    code would not run without the “solution” file
2014-11-08 Box
    just did a first box design and planing on laser cutting before next
    Friday where we can begin trouble shooting or making suggestions for
    final design.
2014-11-09 misc changes to expenses
    added invoice and formatted spreadsheet
    [expenses_Paid.xlsx]
2014-11-09 edits to invoices
    added an invoice from digikey.
    [expenses_Paid.xlsx]
2014-11-10 deleted old code and added new
    I uploaded the most up to date code. it contains all the drivers and
    main.
2014-11-11 Added my expenses to the expenses_Paid.xlsx
    [expenses_Paid.xlsx]
